mmercedes/18-549/website/images/progress/IMG_5437.JPG

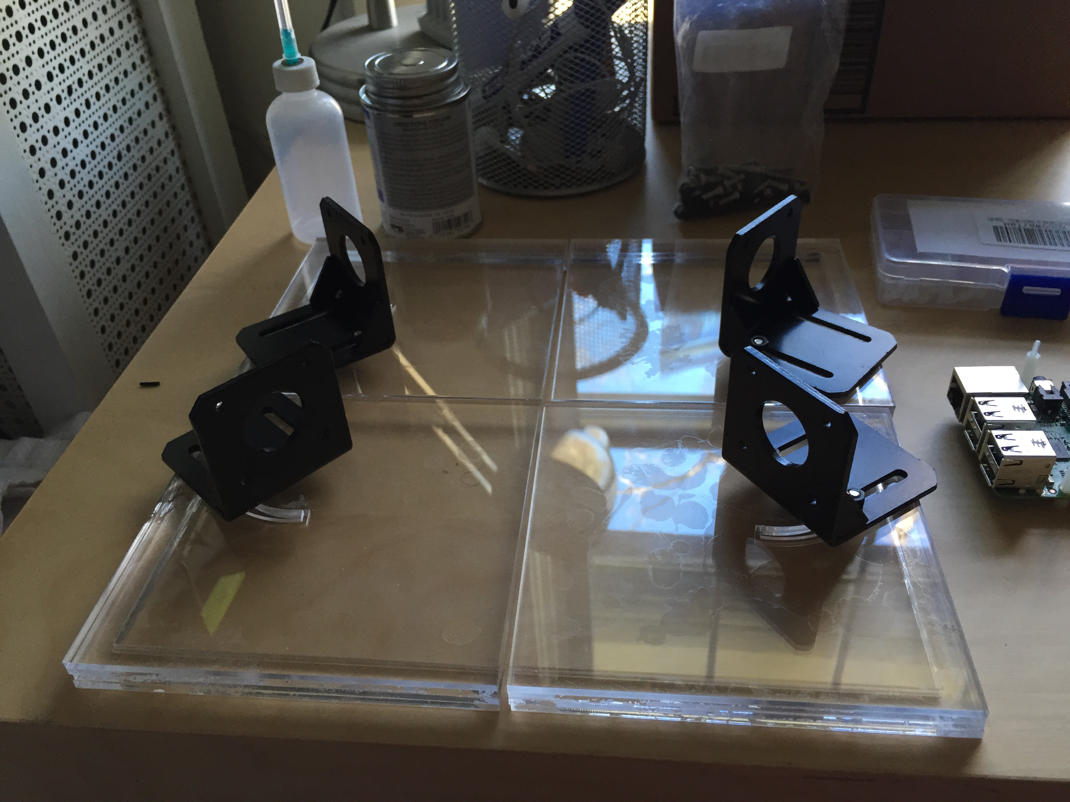
website/images/progress/IMG_5437.JPG
