mmercedes/18-549/website/images/dryplt.PNG

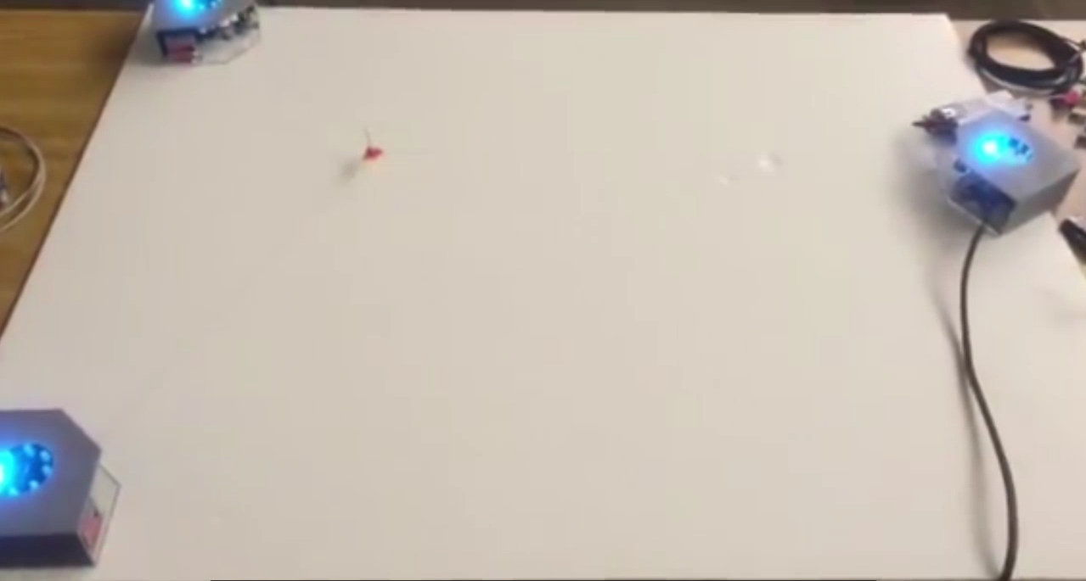
website/images/dryplt.PNG
