mmercedes/18-549/parser/svg.png

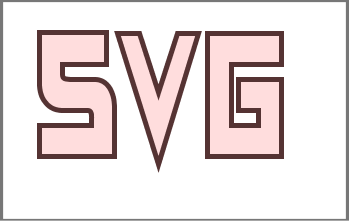
parser/svg.png
