mmercedes/18-549/website/images/basicplotter.JPG

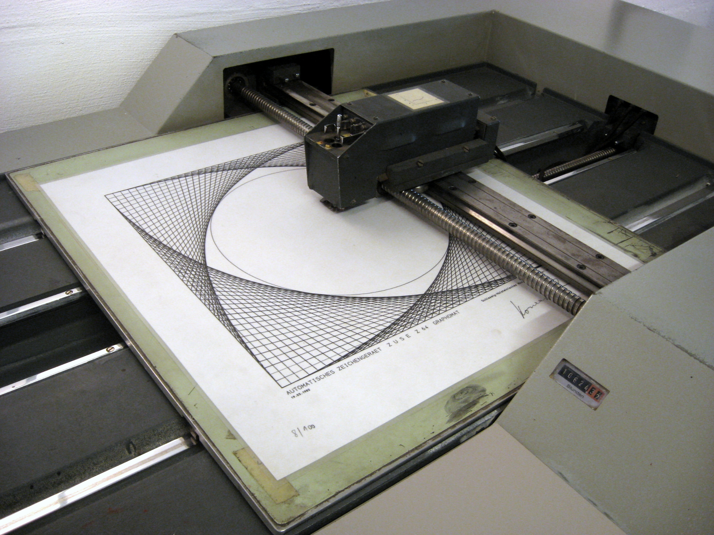
website/images/basicplotter.JPG
