mmercedes/18-549/website/images/cmoscamera.jpg

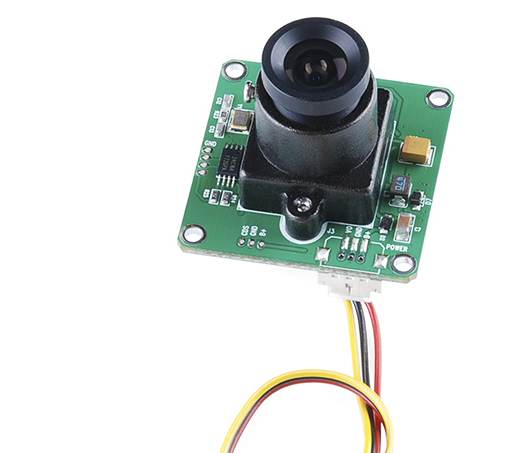
website/images/cmoscamera.jpg
