mmercedes/18-549/website/images/DIAGRAM.png

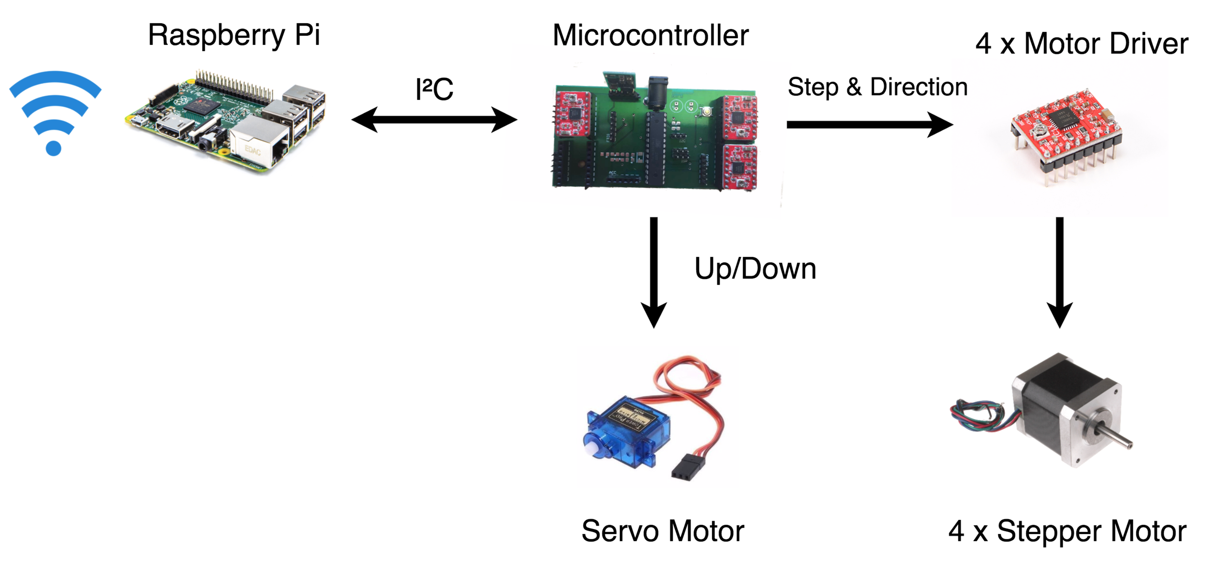
website/images/DIAGRAM.png
