mmercedes/18-549/website/images/graph.jpg

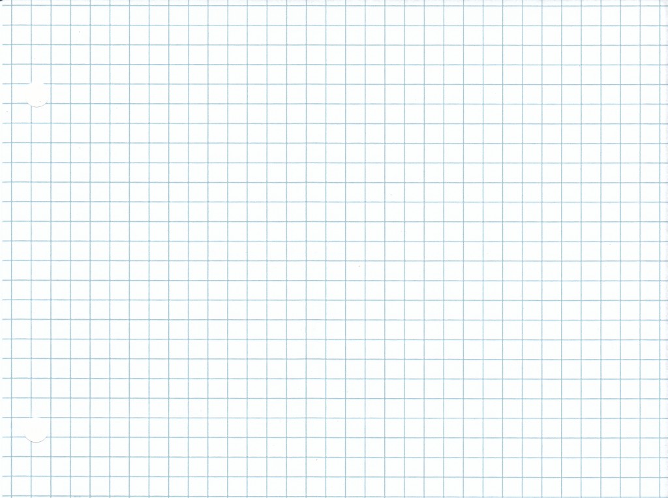
website/images/graph.jpg
