mmercedes/18-549/website/images/jake.jpg

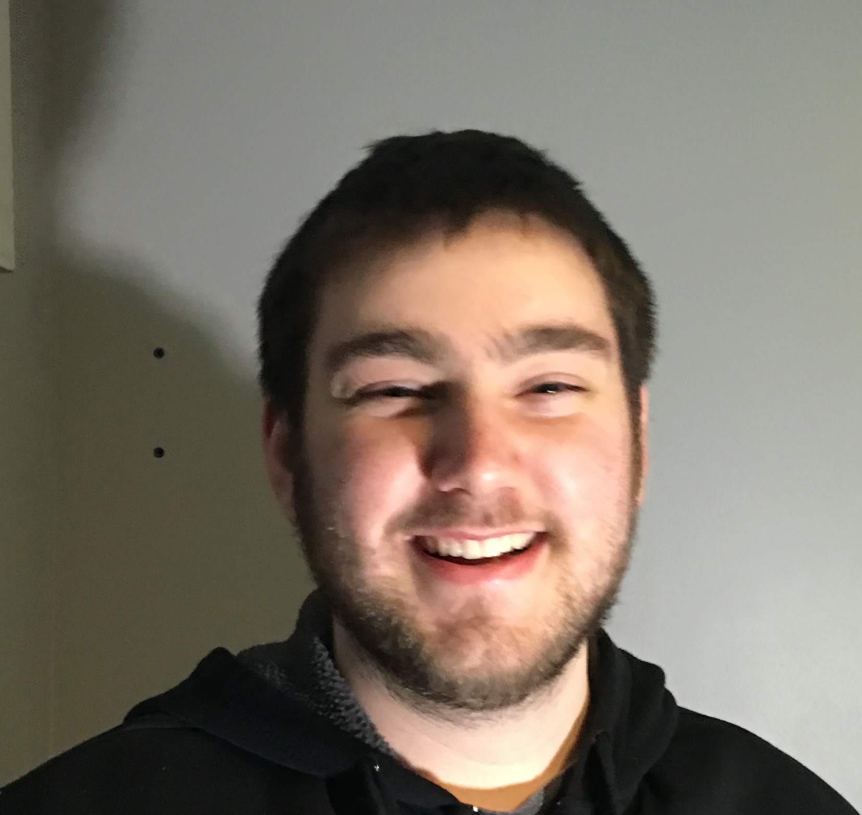
website/images/jake.jpg
