mmercedes/18-549/website/images/lucas.jpg

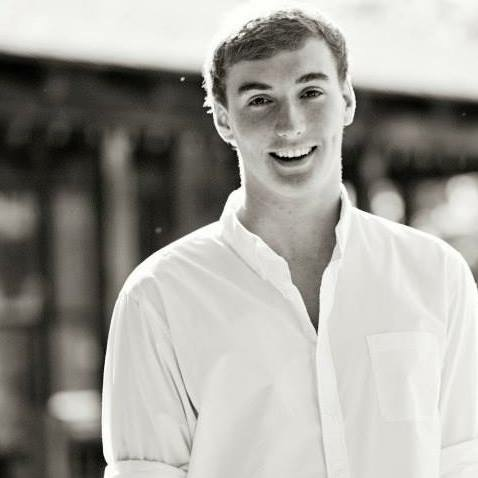
website/images/lucas.jpg
