mmercedes/18-549/website/images/matt.jpg

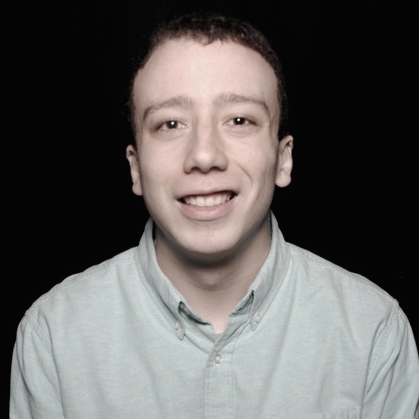
website/images/matt.jpg
