mmercedes/18-549/website/images/progress/image1.JPG

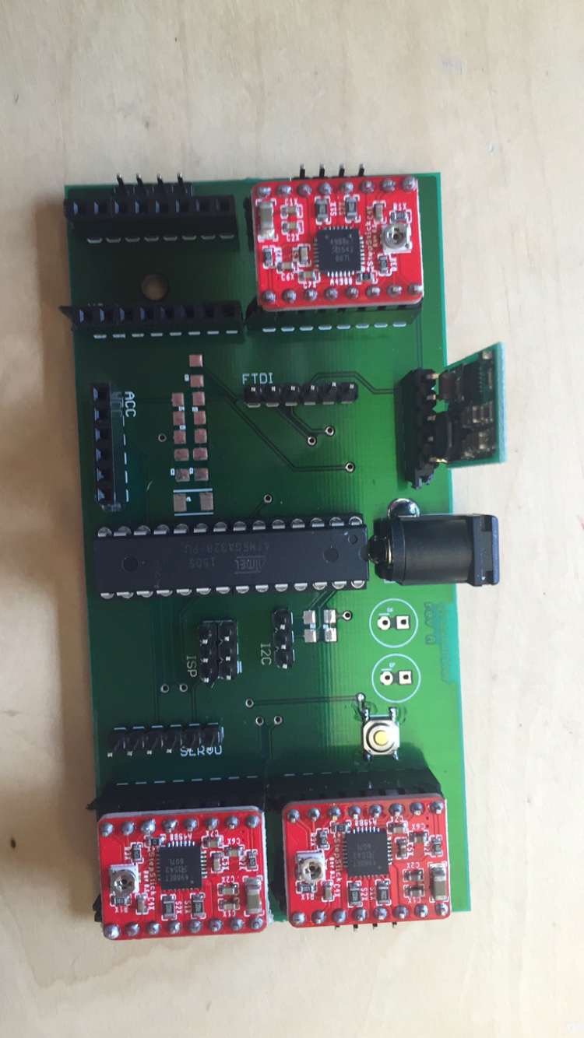
website/images/progress/image1.JPG
