mmercedes/18-549/website/images/progress/IMG_5436.JPG

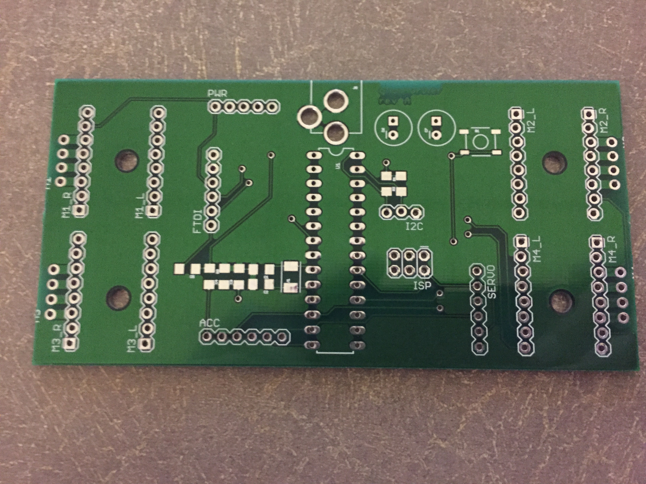
website/images/progress/IMG_5436.JPG
