mmercedes/18-549/website/images/progress/IMG_5438.JPG

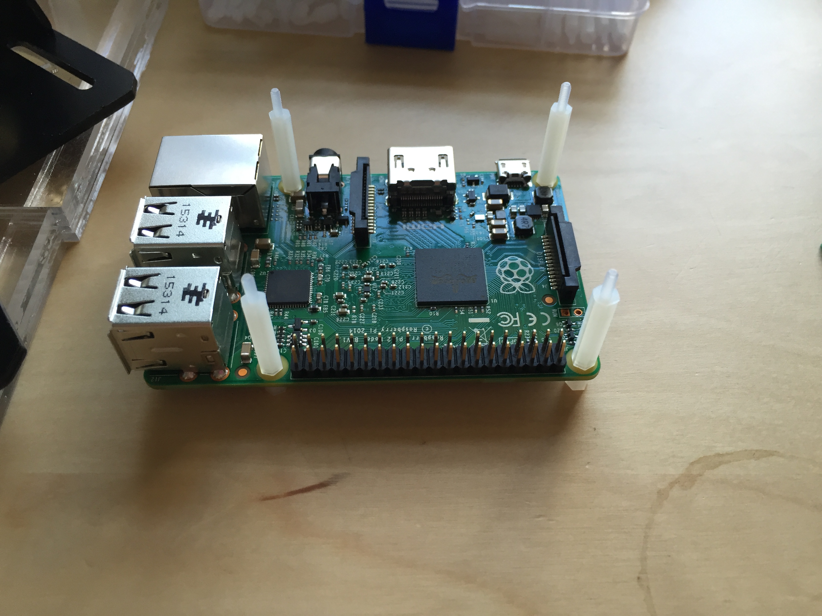
website/images/progress/IMG_5438.JPG
