mmercedes/18-549/website/images/progress/IMG_5439.JPG

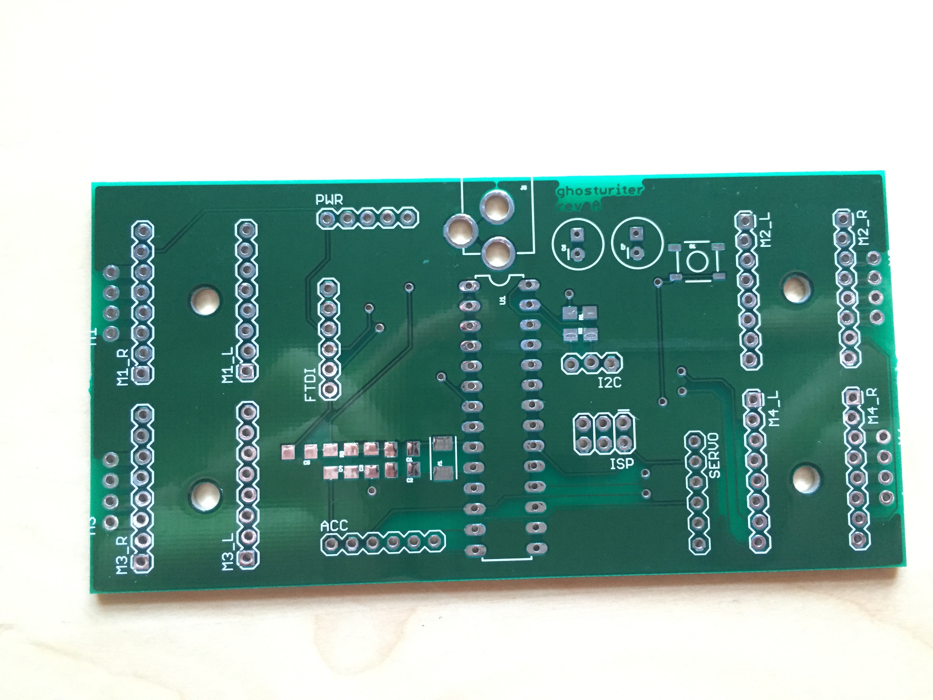
website/images/progress/IMG_5439.JPG
