mmercedes/18-549/website/images/progress/IMG_5440.JPG

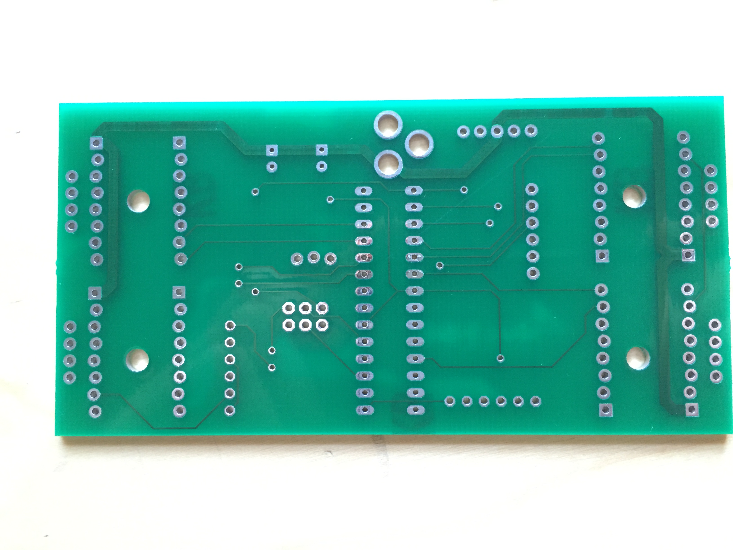
website/images/progress/IMG_5440.JPG
