mmercedes/18-549/website/images/xyplotter1.jpg

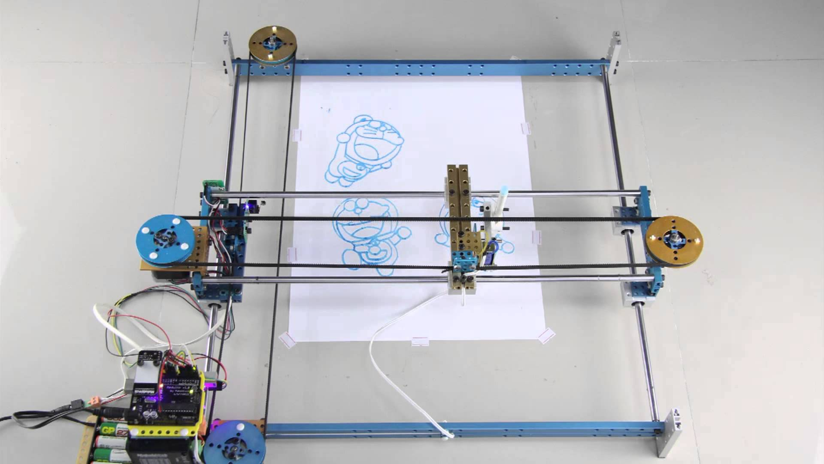
website/images/xyplotter1.jpg
