mmercedes/18-549/website/images/xyplotter2.jpg

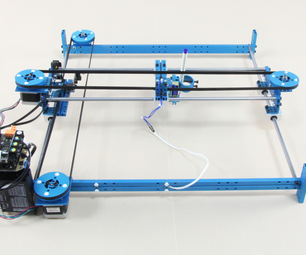
website/images/xyplotter2.jpg
