mmercedes/18-549/website/images/ZarPlotter2.png

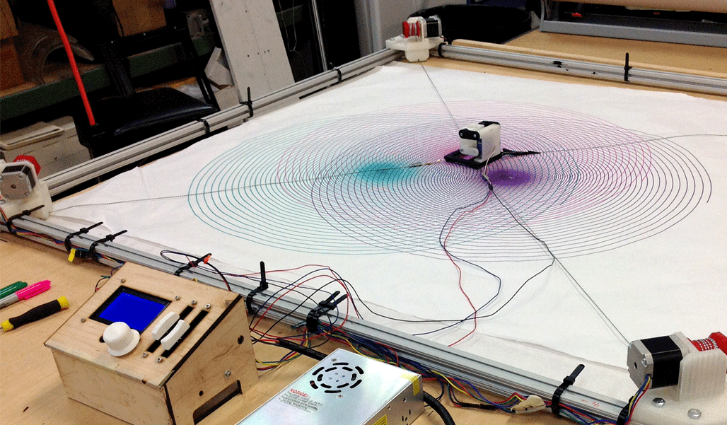
website/images/ZarPlotter2.png
