mmercedes/18-549/ezgif.com-gif-maker.gif

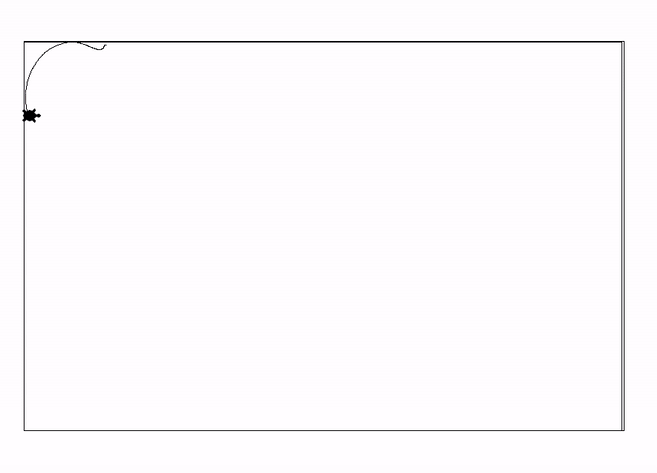
ezgif.com-gif-maker.gif
