mmercedes/18-549/parser/test/1/img/1.png

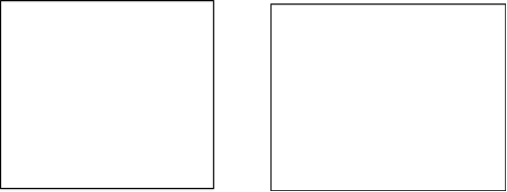
parser/test/1/img/1.png
