mmercedes/18-549/microcontroller/main.ino

/**
  * File: main.c
  * Authors: Lucas Bruder, Matt Mercedes, and Jake Stephens
  * Class: 18-549 Embedded System Design
  * Team 21 - GhostWriter
  * Last Modified: 4/17/2016
  *
  * This file contains the code to be uploaded on the Atmega328p on the PCB
  *
  *
  */

/*****************************************
 *                 INCLUDES              *
 *****************************************/

#include <Arduino.h>
#include <Wire.h>
#include <Servo.h>
#include <AccelStepper.h>
#include <MultiStepper.h>

/*****************************************
 *                 DEFINES               *
 *****************************************/

#define BAUD_RATE             9600
#define I2C_ADDRESS           0x04

#define PIN_MOTOR1_STEP          3
#define PIN_MOTOR1_DIR           2
#define PIN_MOTOR2_STEP         A3
#define PIN_MOTOR2_DIR          A2
#define PIN_MOTOR3_STEP          5
#define PIN_MOTOR3_DIR           4
#define PIN_MOTOR4_STEP         A1
#define PIN_MOTOR4_DIR          A0
#define PIN_SERVO                7

#define MAXSPEED               300

// I2C COMMANDS
#define STOP                     0
#define PEN_UP                   1
#define PEN_DOWN                 2
#define CALIBRATE                3
#define DRAW                     4
#define RESET_TOOL               5
#define DRAWING_CURVE		 6

#define CALIBRATE_STEPS         10

#define START_POS              707

#define CURVE_PATH_LEN		    30
#define NUM_STEPPERS			 4

/*****************************************
 *                 TYPEDEFS              *
 *****************************************/

typedef enum
{
  STATE_WAIT,
  STATE_CALIBRATE,
  STATE_DRAWING,
  STATE_SETUP,
} states_E;

typedef struct
{
  states_E desiredState;
  states_E presentState;
  bool stateTransition;

  bool i2cReceived;
  bool motorsMoving;
  int currentCommand;
    
  char serialByte;
  bool newSerialByte;

  bool newCommand;
  bool gettingCurveCommands;

  uint16_t curvePath[CURVE_PATH_LEN + 1][NUM_STEPPERS];
  uint8_t  curvePathIndex;
  bool drawingCurve;


} data_S;

/*****************************************
 *             FUNCTION HEADERS          *
 *****************************************/

void i2c_rec_handler(int numBytesReceived);
void i2c_req_handler();

void processData(void);
void getDesiredState(void);
void setCurrentState(void);

void setup(void);
void loop(void);

// Calibrate transitions
inline bool allowTransitionCalibrateToDrawing(void);
inline bool allowTransitionCalibrateToWait(void);

// Drawing transitions
inline bool allowTransitionDrawingToCalibrate(void);
inline bool allowTransitionDrawingToWait(void);

// Wait transitions
inline bool allowTransitionWaitToDrawing(void);
inline bool allowTransitionWaitToCalibrate(void);

// Motor movement functions
/*
boolean moveMotor1(int x);
boolean moveMotor2(int x);
boolean moveMotor3(int x);
boolean moveMotor4(int x);
*/

void movePenUp();
void movePenDown();

/*****************************************
 *              VARIABLES                *
 *****************************************/

data_S data;

AccelStepper stepper_1(1,PIN_MOTOR1_STEP, PIN_MOTOR1_DIR);
AccelStepper stepper_2(1,PIN_MOTOR2_STEP, PIN_MOTOR2_DIR);
AccelStepper stepper_3(1,PIN_MOTOR3_STEP, PIN_MOTOR3_DIR);
AccelStepper stepper_4(1,PIN_MOTOR4_STEP, PIN_MOTOR4_DIR);

MultiStepper steppers;

long new_positions[4];

Servo penServo;

/*****************************************
 *          HELPER FUNCTIONS             *
 *****************************************/

/**
  * I2C handler called when a message is received
  */
void i2c_rec_handler(int numBytesReceived)
{
    int buf [9];
    int i = 0;
    
    while(Wire.available()) {
        buf[i] = Wire.read();
        i++;
    }
    new_positions[0] = buf[0] * 256 + buf[1];
    new_positions[1] = buf[2] * 256 + buf[3];
    new_positions[2] = buf[4] * 256 + buf[5];
    new_positions[3] = buf[6] * 256 + buf[7];
    data.currentCommand = buf[8];
    Serial.println(" ");
    Serial.print("I2C received : ");
    Serial.print(new_positions[0]);
    Serial.print("\t");    
    Serial.print(new_positions[1]);
    Serial.print("\t");
    Serial.print(new_positions[2]);
    Serial.print("\t");
    Serial.print(new_positions[3]);
    Serial.print("\t");
    Serial.println(buf[8]);
    data.i2cReceived = true;

    if(data.currentCommand == RESET_TOOL)
    {
        new_positions[0] = START_POS;
        new_positions[1] = START_POS;
        new_positions[2] = START_POS;
        new_positions[3] = START_POS;
        steppers.moveTo(new_positions);
        Serial.println("RESET");
    }

    // put any bytes received during the drawing curve command into the curvePath array
    // 
    if(data.gettingCurveCommands == true)
    {
    	data.curvePath[data.curvePathIndex][0] = new_positions[0];
    	data.curvePath[data.curvePathIndex][1] = new_positions[1];
    	data.curvePath[data.curvePathIndex][2] = new_positions[2];
    	data.curvePath[data.curvePathIndex][3] = new_positions[3];

    	data.curvePathIndex++;

        Serial.println(data.curvePathIndex);

    }

    if(data.currentCommand == DRAWING_CURVE && data.gettingCurveCommands == false)
    {
        data.gettingCurveCommands = true;
        data.curvePathIndex = 0; // must be reset before we use it in the output functino
        data.drawingCurve = false;
    }
    
    if(data.curvePathIndex == CURVE_PATH_LEN + 1)
    {
        data.gettingCurveCommands = false;
        data.curvePathIndex = 0;
        data.drawingCurve = true;
    }
}

void i2c_req_handler()
{
    if(data.presentState == STATE_WAIT) {
        Wire.write(2);
    } else {
        Wire.write(1);
    }
}

/**
  * Check for transition from wait to calibration.
  * Allow transition from wait to calibrate if
  *
  */
inline bool allowTransitionWaitToCalibrate(void)
{
  bool allowTransition = false;

  if(data.currentCommand == CALIBRATE && data.newCommand)
  {
    allowTransition = true;
  }

  // serial case
  if(data.newSerialByte == true && (data.serialByte == 'c'))
  {
    allowTransition = true;
  }
  return allowTransition;
}

/**
  * Check for transition from wait to drawing.
  * Allow transition from wait to drawing if
  *
  */
inline bool allowTransitionWaitToDrawing(void)
{
    bool allowTransition = false;
    int command = data.currentCommand;

    if((data.newCommand == true) && ( (command == DRAW) || (command == PEN_UP) || (command == PEN_DOWN) || (command == RESET_TOOL) ))
    {
        allowTransition = true;
    }
    else if(data.drawingCurve == true)
    {
        allowTransition = true;
    }

    return allowTransition; 
}

/**
  * Check for transition from drawing to wait.
  * Allow transition from drawing to wait if
  *
  */
inline bool allowTransitionDrawingToWait(void)
{
  bool allowTransition = false;

  if(!data.motorsMoving || (data.newCommand == true && data.currentCommand == STOP))
  {
      allowTransition = true;
  }
  
  return allowTransition;
}

/**
  * Check for transition from calibrate to wait.
  * Allow transition from calibrate to wait if
  *
  */
inline bool allowTransitionCalibrateToWait(void)
{
  bool allowTransition = false;

  if(!data.motorsMoving || (data.newCommand == true && data.currentCommand == STOP))
  {
          allowTransition = true;
  }

  // serial case
  if(data.newSerialByte == true && (data.serialByte == 'w'))
  {
    allowTransition = true;
  }

  return allowTransition;
}

/**
  * Check for transition from wait to setup.
  * Allow transition from wait to setup if we get a 's' on serial
  *
  */
inline bool allowTransitionWaitToSetup(void)
{
	bool allowTransition = false;

	if(data.newSerialByte == true && data.serialByte == 's')
	{
		allowTransition = true;
	}

	return allowTransition;
}


/**
  * Check for transition from setup to wait.
  * Allow transition from setup to wait if we get a 'w' on serial
  *
  */
inline bool allowTransitionSetupToWait(void)
{
	bool allowTransition = false;

	if(data.newSerialByte == true && data.serialByte == 'w')
	{
		allowTransition = true;
	}

	return allowTransition;
}

/*
 * Process inputs
 */
void processData(void)
{
    if(Serial.available() == true)
    {
        data.serialByte = Serial.read();
        data.newSerialByte = true;
    }

    if(data.i2cReceived == true)
    {
        data.newCommand = true;
        data.i2cReceived = false;
    }
    else
        {
            data.newCommand = false;
        }
}

/*
 * Get the present state and determine if a state transition shall be performed. If so, set the 
 * desired state to that new state.
 */
void getDesiredState(void)
{
  states_E desiredState = data.desiredState;

  switch(desiredState)
  {
    case STATE_WAIT:
      if(allowTransitionWaitToCalibrate() == true)
      {
        desiredState = STATE_CALIBRATE;
      }
      else if(allowTransitionWaitToDrawing() == true)
      {
        desiredState = STATE_DRAWING;
      }
      else if(allowTransitionWaitToSetup() == true)
      {
      	desiredState = STATE_SETUP;
      }
      else
      {
        // keep state
      }

      break;

    case STATE_SETUP:
    	if(allowTransitionSetupToWait() == true)
    	{
    		desiredState = STATE_WAIT;
    	}
    	else
    	{
    		// keep state
    	}

    	break;

    case STATE_CALIBRATE:
      if(allowTransitionCalibrateToWait() == true)
      {
        desiredState = STATE_WAIT;
      }
      else
      {
        // keep state
      }
      break;

    case STATE_DRAWING:
      if(allowTransitionDrawingToWait() == true)
      {
          desiredState = STATE_WAIT;
      }
      else
      {
        // keep state
      }
      break;

    default:
      // should never reach here, error
      break;
  }
    
  data.desiredState = desiredState;
}

/*
 * Perform any transition and state related outputs
 */
void setCurrentState(void)
{
    states_E state = data.desiredState;

    switch(state)
    {
      case STATE_WAIT:
        if(data.stateTransition)
        {
            Serial.println("WAIT");
        }

        data.motorsMoving = false;

        break;

      case STATE_SETUP:
      	if(data.stateTransition)
      	{
      		Serial.println("--> SETUP STATE");
      		Serial.println("Press 1,2,3 or 4 for which motor you want to spin");
      	}

      	break;

      case STATE_CALIBRATE:
        if(data.stateTransition)
        {
            Serial.println("CALIBRATE");
            
            new_positions[0] = stepper_1.currentPosition() - CALIBRATE_STEPS;
            new_positions[1] = stepper_2.currentPosition() - CALIBRATE_STEPS;
            new_positions[2] = stepper_3.currentPosition() - CALIBRATE_STEPS;
            new_positions[3] = stepper_4.currentPosition() - CALIBRATE_STEPS;            
            steppers.moveTo(new_positions);
        }

        data.motorsMoving = steppers.run();
        
        if(!data.motorsMoving){
            stepper_1.setCurrentPosition(START_POS);
            stepper_2.setCurrentPosition(START_POS);
            stepper_3.setCurrentPosition(START_POS);
            stepper_4.setCurrentPosition(START_POS);
            Serial.println("CALIBRATED");
        } else {
            Serial.println("STEP");
        }
        break;

      case STATE_DRAWING:
        if(data.stateTransition)
        {
            Serial.println("DRAW STATE");
        }

        // if we received a new command, perform output
        if(data.newCommand){
            if(data.currentCommand == DRAW) {
                Serial.println("DRAW");
                steppers.moveTo(new_positions);
            } else if(data.currentCommand == PEN_UP) {
                movePenUp();
                data.motorsMoving = false;
            } else if(data.currentCommand == PEN_DOWN) {
                movePenDown();
                data.motorsMoving = false;
            }
        }

        // if the motors aren't moving and we're in the drawing curve state,
        // choose a new position to go to on the curve
        if((data.motorsMoving == false) && (data.drawingCurve == true))
        {
        	long stepper_positions[NUM_STEPPERS];

        	Serial.println("DRAWING CURVE");

        	stepper_positions[0] = data.curvePath[data.curvePathIndex][0];
        	stepper_positions[1] = data.curvePath[data.curvePathIndex][1];
        	stepper_positions[2] = data.curvePath[data.curvePathIndex][2];
        	stepper_positions[3] = data.curvePath[data.curvePathIndex][3];

         	steppers.moveTo(stepper_positions);

        	data.curvePathIndex++;

        	if(data.curvePathIndex == CURVE_PATH_LEN) // reached the end of the curve path
        	{
        		data.drawingCurve = false;
                        data.curvePathIndex = 0;
                        Serial.println("Done drawing curve");
                }
        }

        data.motorsMoving = steppers.run();
        
        break;

      default:
        // should never reach here, error
          Serial.println("ERROR, IN DEFAULT");
        break;
    }
    // if(!data.motorsMoving){
    //     data.nextCommand = STOP;
    // }
    data.presentState = state;
}

void movePenUp() {
    Serial.println("PEN UP");
    penServo.write(180);
}

void movePenDown() {
    Serial.println("PEN DOWN");
    penServo.write(0);
}

/*****************************************
 *             MAIN FUNCTION             *
 *****************************************/

void setup(void)
{
  Serial.begin(BAUD_RATE);
  Serial.println("-> Starting GhostWriter");

  // Setup i2c communication
  data.i2cReceived = false;
  Wire.begin(I2C_ADDRESS);
  Wire.onReceive(i2c_rec_handler);
  Wire.onRequest(i2c_req_handler);

  /*
   * SETUP MOTOR DIRECTION AND STEP PINS AS OUTPUTS
   */
  stepper_1.setCurrentPosition(START_POS);
  stepper_2.setCurrentPosition(START_POS);
  stepper_3.setCurrentPosition(START_POS);
  stepper_4.setCurrentPosition(START_POS);
  
  stepper_1.setMaxSpeed(MAXSPEED);
  stepper_2.setMaxSpeed(MAXSPEED);
  stepper_3.setMaxSpeed(MAXSPEED);
  stepper_4.setMaxSpeed(MAXSPEED);  
  
  steppers.addStepper(stepper_1);
  steppers.addStepper(stepper_2);
  steppers.addStepper(stepper_3);
  steppers.addStepper(stepper_4);  
  
  penServo.attach(PIN_SERVO);

  data.currentCommand = STOP;
  data.presentState = STATE_WAIT;
  data.desiredState = STATE_WAIT;
  data.drawingCurve = false;
}

void loop(void)
{
  processData();

  getDesiredState();

  data.stateTransition = (data.desiredState != data.presentState);

  setCurrentState();
  
  data.newSerialByte = false;
  //data.i2cReceived = false;

}
