mmercedes/18-549/(commit log)

2016-03-27 Copied in stepper motor controller code
2016-03-28 adding accelstepper lib
    [project.cfg]
2016-04-02 added architecture and use case section sort of
2016-04-03 completed arduino makefile, can write test programs to the microcontroller
2016-04-04 i2c code
2016-04-04 got pi to communicate to microcontroller over i2c
2016-04-25 adding motor functions to main.ino
2016-04-25 updated i2c files so that there is communication both ways
2016-04-25 added i2c communication to main.ino
2016-04-27 added penUp, penDown and calibrate commands
